JakeHartline/X200-docs/README.md

Sharing some knowledge I gathered owning a Thinkpad X200.
Things here are more or less WIP.

- [Flashing libreboot](flashing.md)
- [Working RAM](supported-RAM.md)
