JakeHartline/X200-docs/jig/springs.stl

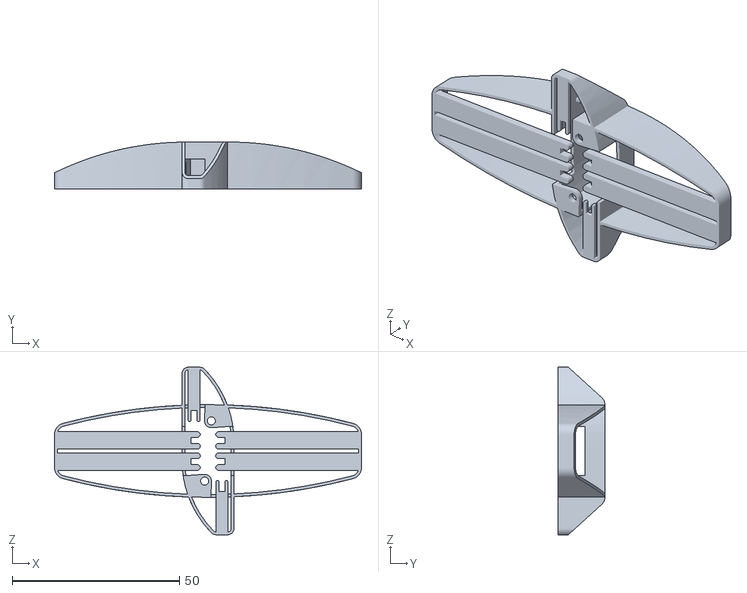
[picture p4: CAD file, 2020-12-30]
jig/springs.stl
91.7 x 14.0 x 50.0
