JakeHartline/X200-docs/jig/base.stl

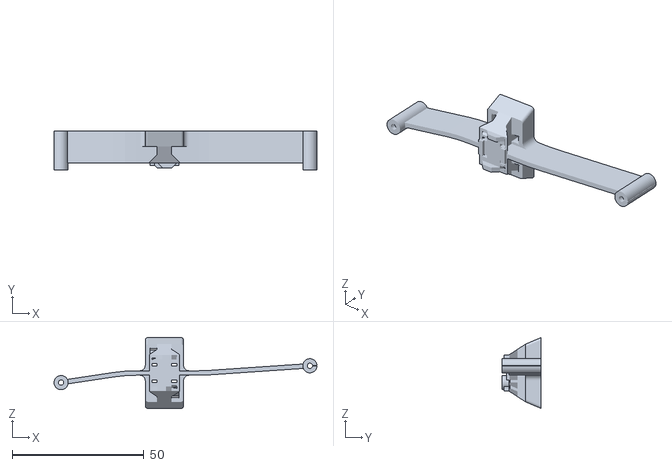
[picture p5: CAD file, 2020-12-30]
jig/base.stl
100.0 x 15.0 x 27.0
